yasirACTUALY/Leaf-vac/calibration/right/right_image_1.png

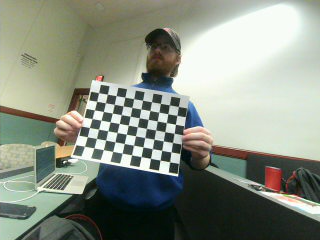
calibration/right/right_image_1.png
