yasirACTUALY/Leaf-vac/calibration/right/right_image_4.png

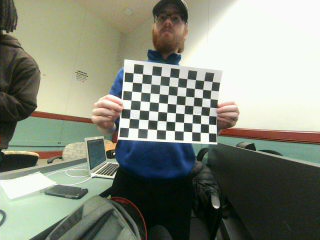
calibration/right/right_image_4.png
