yasirACTUALY/Leaf-vac/C1.jpg

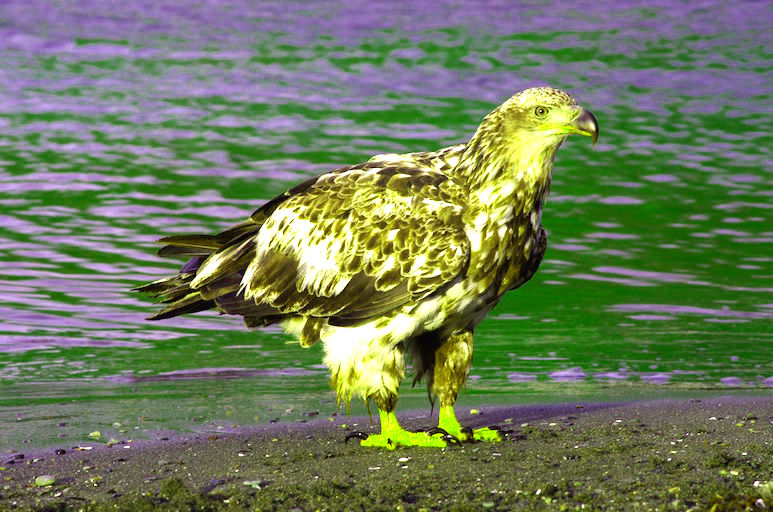
C1.jpg
