yasirACTUALY/Leaf-vac/C2.jpg

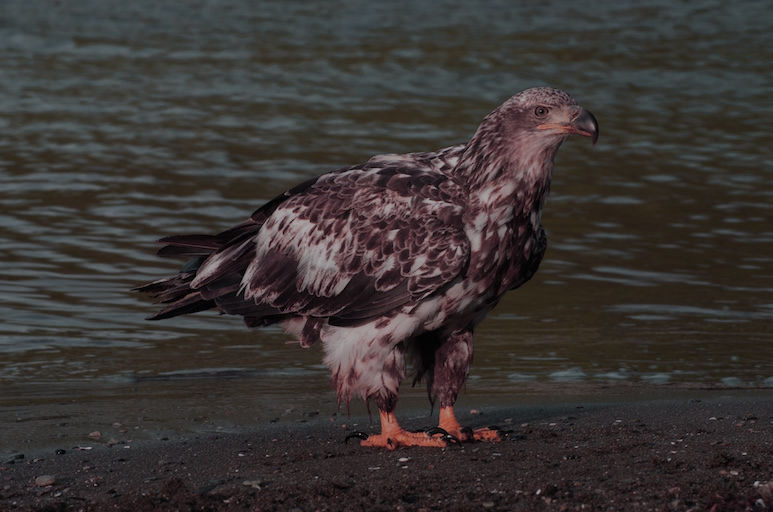
C2.jpg
