yasirACTUALY/Leaf-vac/demo/LeafVac Poster.png

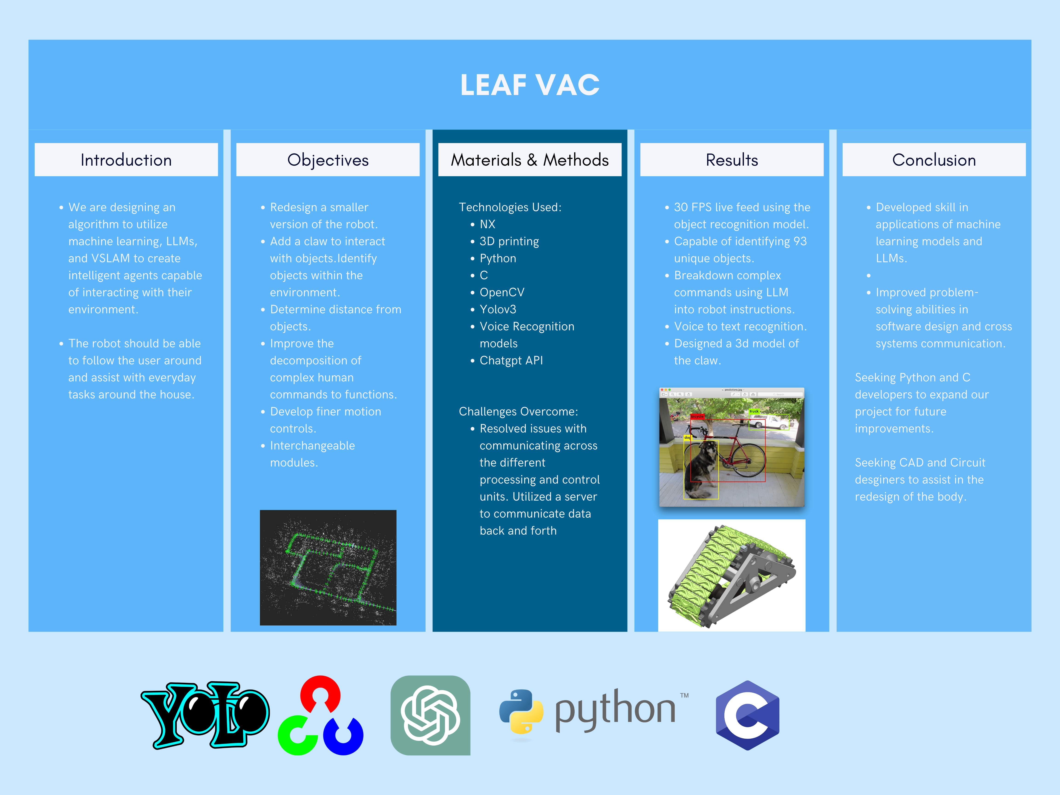
demo/LeafVac Poster.png
