yasirACTUALY/Leaf-vac/CAD/basebase.stl

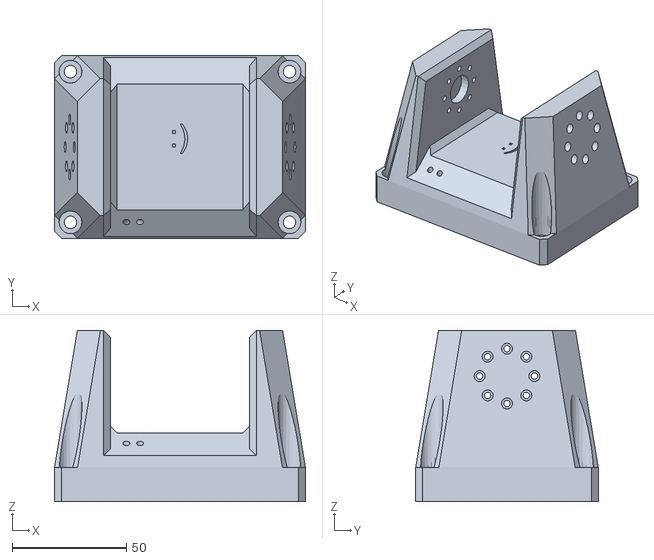
[picture p19: CAD file, 2024-12-07]
CAD/basebase.stl
110.0 x 80.0 x 75.0
