yasirACTUALY/Leaf-vac/CAD/pickupcube.stl

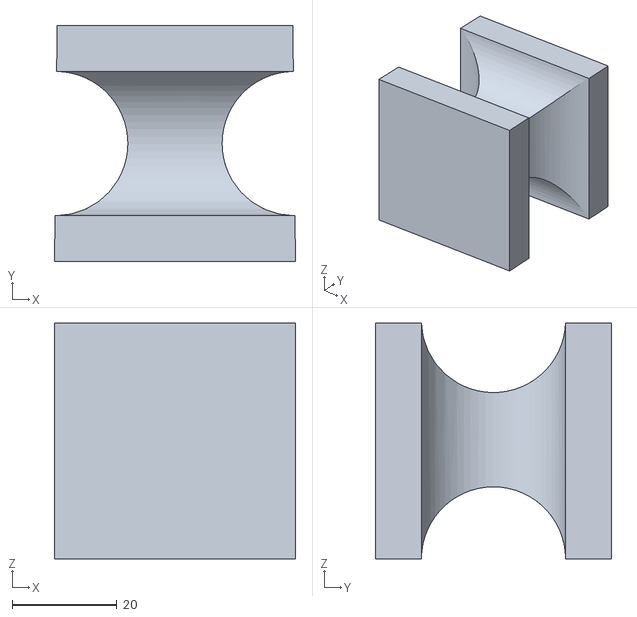
[picture p20: CAD file, 2024-12-07]
CAD/pickupcube.stl
46.0 x 45.0 x 45.0
