yasirACTUALY/Leaf-vac/CAD/basesupport.stl

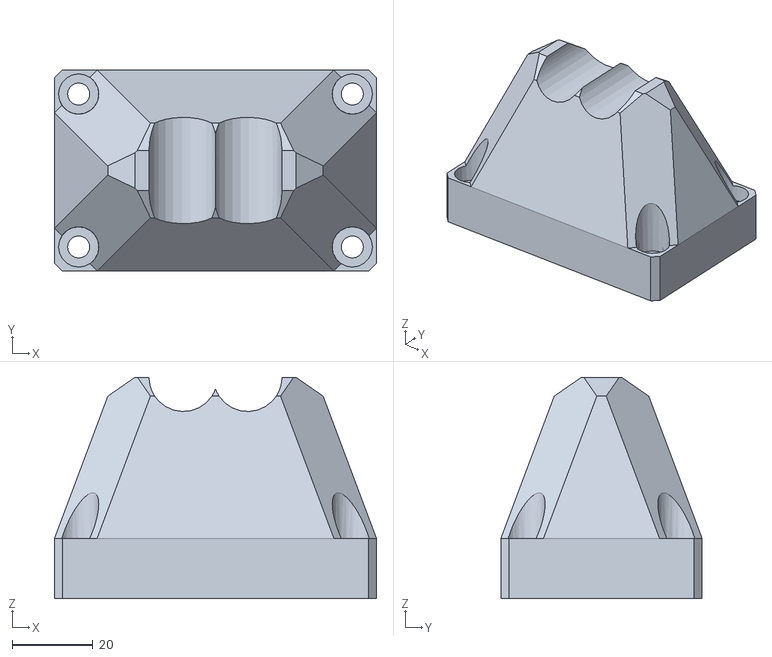
[picture p21: CAD file, 2024-12-07]
CAD/basesupport.stl
80.0 x 50.0 x 55.0
