yasirACTUALY/Leaf-vac/CAD/scoop.stl

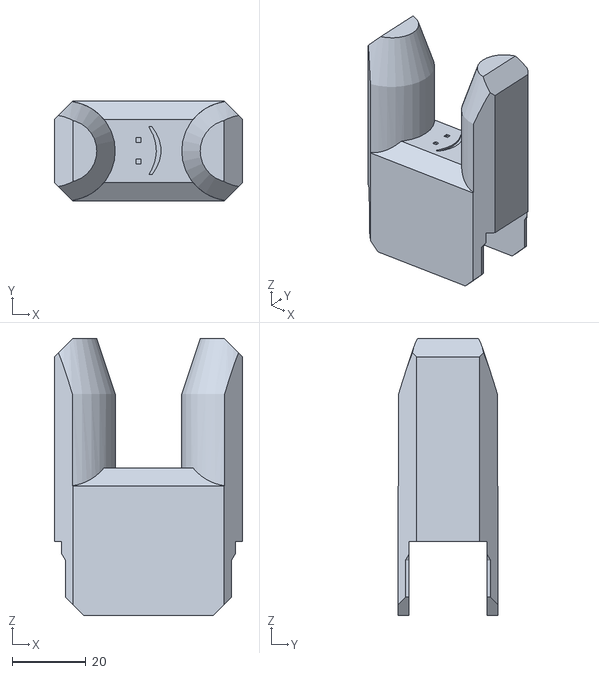
[picture p22: CAD file, 2024-12-07]
CAD/scoop.stl
51.0 x 27.0 x 75.0
