yasirACTUALY/Leaf-vac/CAD/pickupcube_1.stl

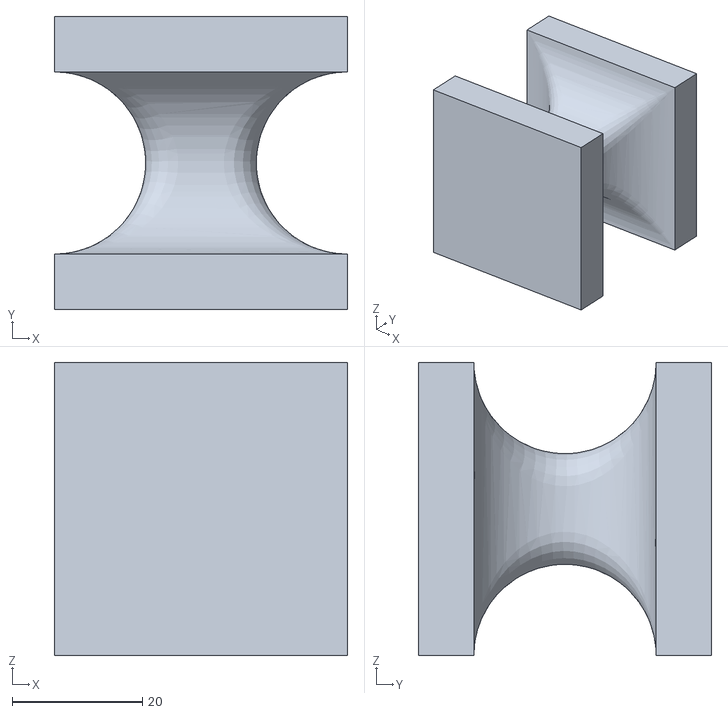
[picture p23: CAD file, 2024-12-07]
CAD/pickupcube_1.stl
45.0 x 45.0 x 45.0
