yasirACTUALY/Leaf-vac/CAD/joint1b.stl

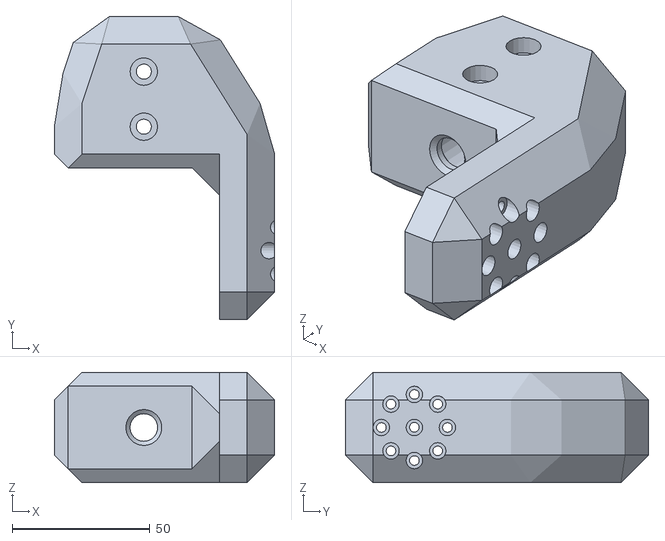
[picture p24: CAD file, 2024-10-22]
CAD/joint1b.stl
80.0 x 110.0 x 40.0
