yasirACTUALY/Leaf-vac/CAD/tubeclamp.stl

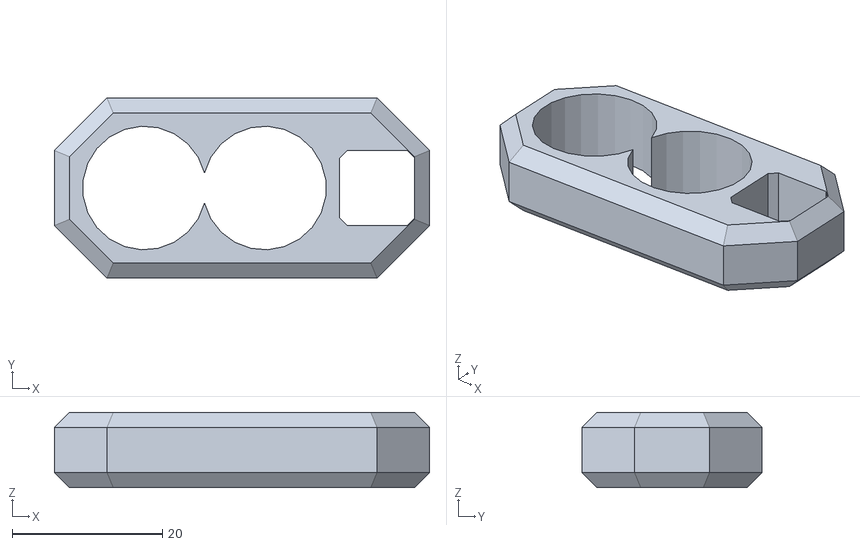
[picture p25: CAD file, 2024-10-22]
CAD/tubeclamp.stl
50.0 x 24.0 x 10.0
