yasirACTUALY/Leaf-vac/CAD/joint1c.stl

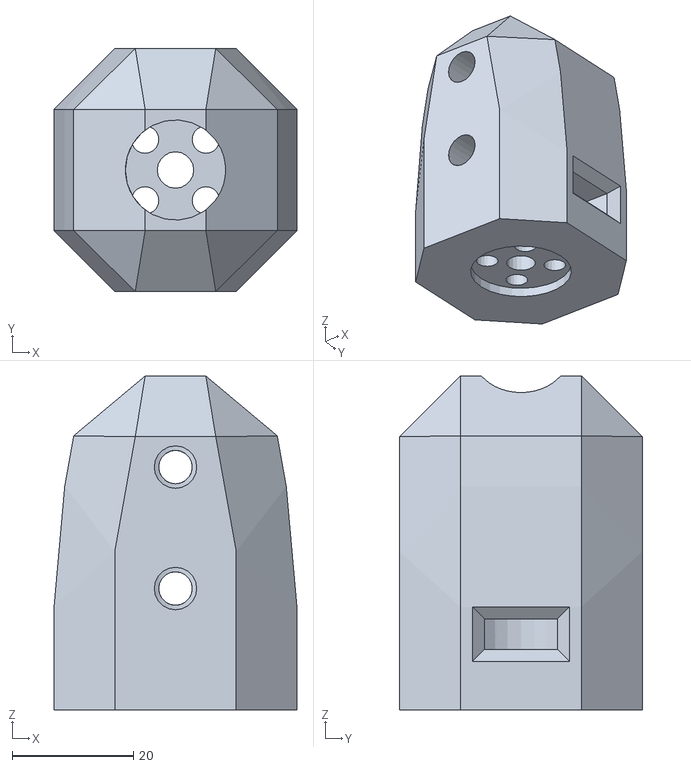
[picture p26: CAD file, 2024-10-22]
CAD/joint1c.stl
40.0 x 40.0 x 55.0
