yasirACTUALY/Leaf-vac/CAD/joint2.stl

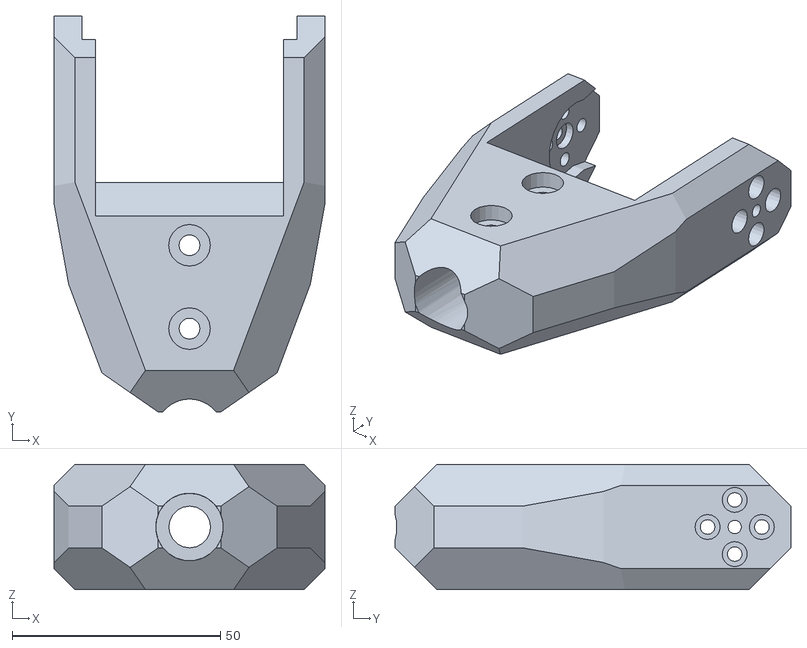
[picture p27: CAD file, 2024-10-22]
CAD/joint2.stl
65.0 x 95.0 x 30.0
