yasirACTUALY/Leaf-vac/CAD/baseb.stl

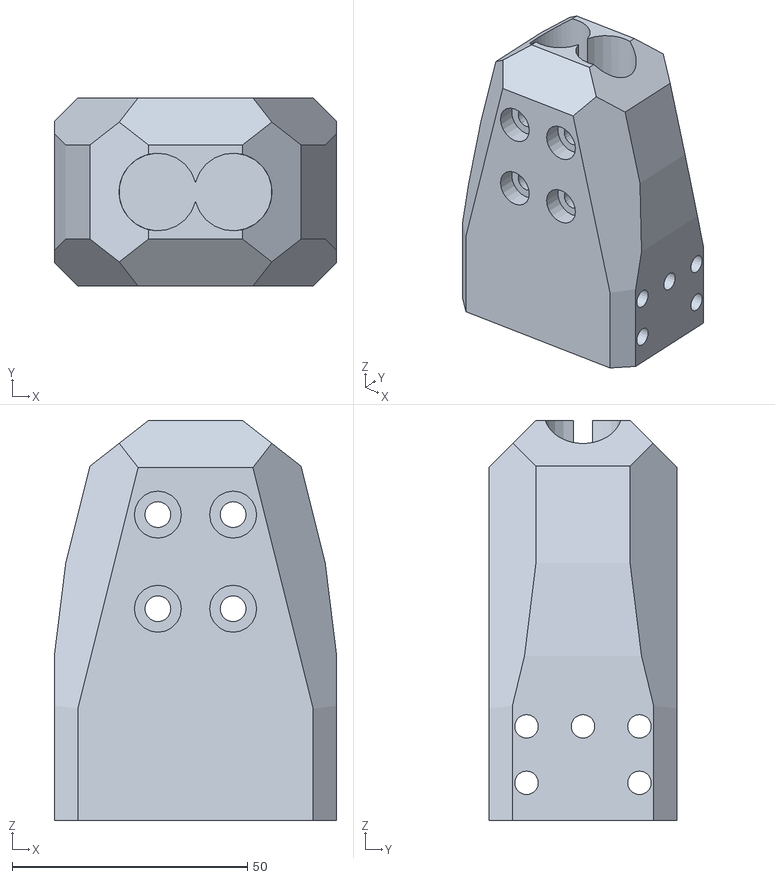
[picture p28: CAD file, 2024-10-22]
CAD/baseb.stl
60.0 x 40.0 x 85.0
