yasirACTUALY/Leaf-vac/CAD/drillblock.stl

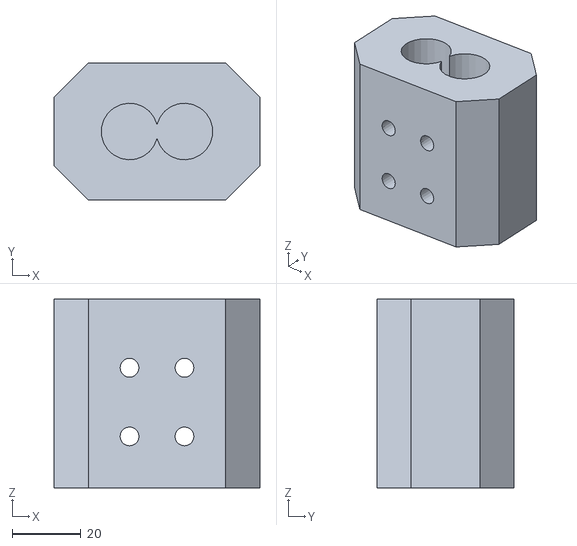
[picture p29: CAD file, 2024-10-22]
CAD/drillblock.stl
60.0 x 40.0 x 55.0
