yasirACTUALY/Leaf-vac/CAD/joint1b2.stl

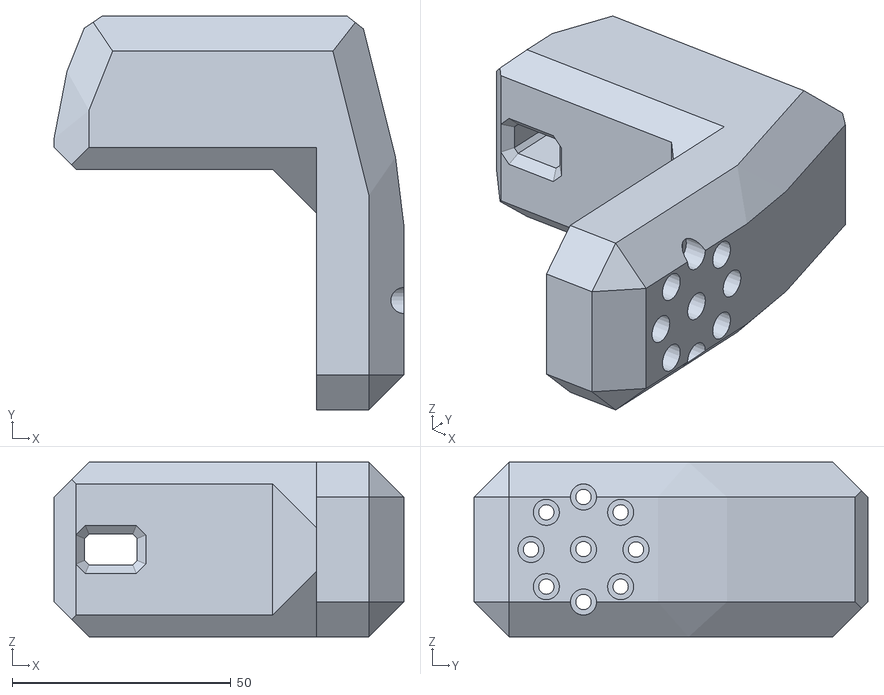
[picture p30: CAD file, 2024-10-22]
CAD/joint1b2.stl
80.0 x 90.0 x 40.0
