yasirACTUALY/Leaf-vac/CAD/joint1.stl

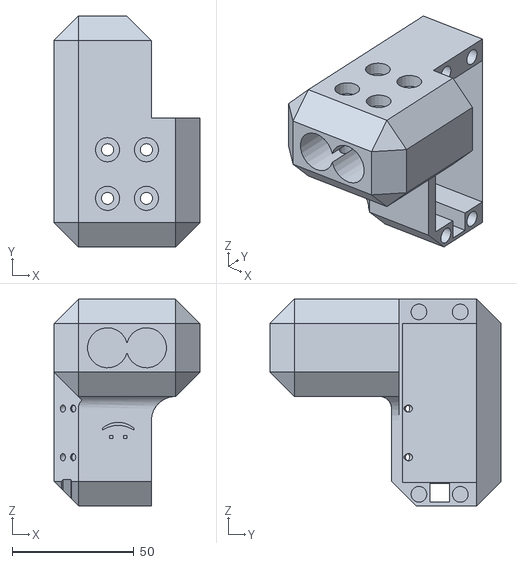
[picture p31: CAD file, 2024-10-11]
CAD/joint1.stl
60.0 x 95.0 x 85.0
