yasirACTUALY/Leaf-vac/CAD/25kgservo.stl

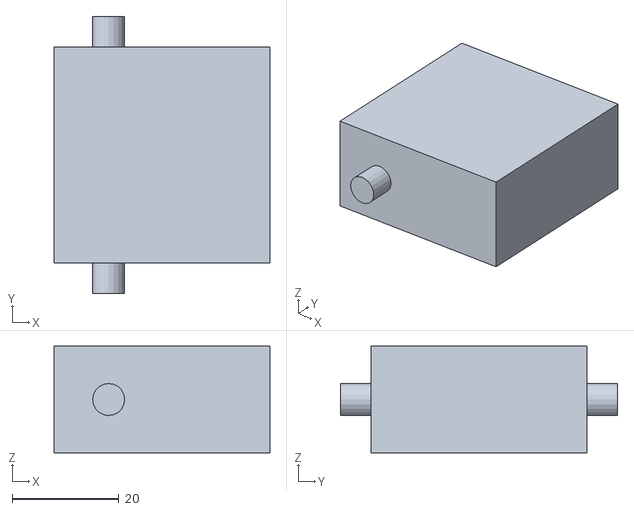
[picture p32: CAD file, 2024-10-11]
CAD/25kgservo.stl
40.5 x 52.0 x 20.0
