yasirACTUALY/Leaf-vac/CAD/80kgservo.stl

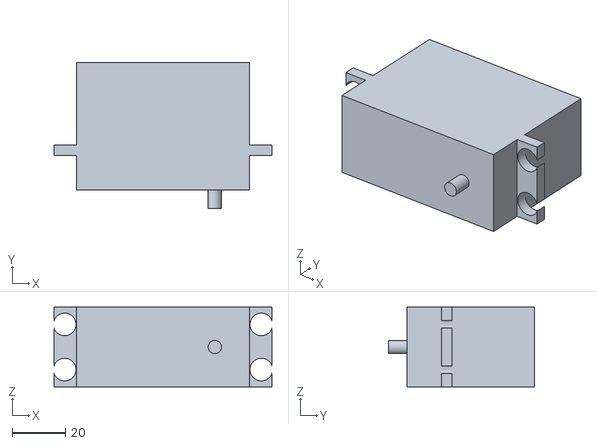
[picture p33: CAD file, 2024-10-04]
CAD/80kgservo.stl
82.0 x 55.0 x 30.0
