yasirACTUALY/Leaf-vac/CAD/carbontube250mm.stl

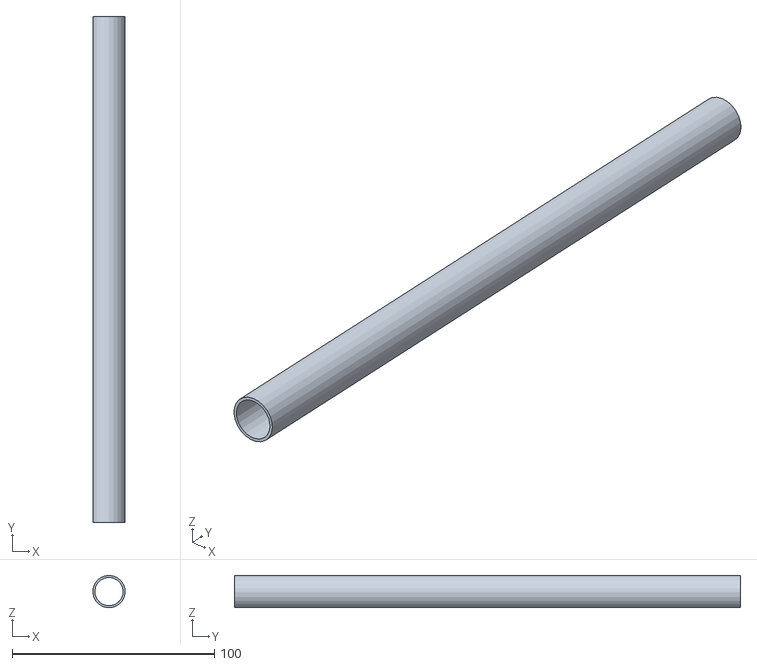
[picture p34: CAD file, 2024-10-04]
CAD/carbontube250mm.stl
16.0 x 250.0 x 15.9
