yasirACTUALY/Leaf-vac/(list of files, cad)

Other CAD files:
CAD/25kgservo.prt
CAD/80kgservo.prt
CAD/baseb.prt
CAD/basebase.prt
CAD/basejoint.prt
CAD/basesupport.prt
CAD/carbontube150mm.prt
CAD/carbontube200mm.prt
CAD/drillblock.prt
CAD/joint1.prt
CAD/joint1b.prt
CAD/joint1b2.prt
CAD/joint1c.prt
CAD/joint2.prt
CAD/pickup.prt
CAD/pickupcube.prt
CAD/scoop.prt
CAD/tubeclamp.prt
