yasirACTUALY/Leaf-vac/Motor Control/Documentation/Wheel Motor Code Test.txt

// Motor A
int motor1Pin1 = 27; 
int motor1Pin2 = 26; 

// Setting PWM properties
const int freq = 30000;
const int pwmChannel = 0;
const int resolution = 8;
int dutyCycle = 200;

void setup() {
  // sets the pins as outputs:
  pinMode(motor1Pin1, OUTPUT);
  pinMode(motor1Pin2, OUTPUT);
  
}

void loop() {
  // Move the DC motor forward at maximum speed
  digitalWrite(motor1Pin1, LOW);
  digitalWrite(motor1Pin2, HIGH); 
  delay(2000);

  // Stop the DC motor
  digitalWrite(motor1Pin1, LOW);
  digitalWrite(motor1Pin2, LOW);
  delay(1000);

  // Move DC motor backwards at maximum speed
  digitalWrite(motor1Pin1, HIGH);
  digitalWrite(motor1Pin2, LOW); 
  delay(2000);

}
