yasirACTUALY/Leaf-vac/calibration/left/left_image_1.png

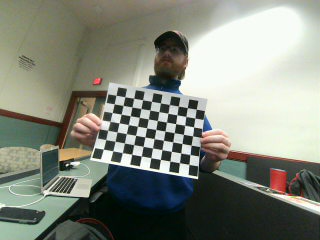
calibration/left/left_image_1.png
