yasirACTUALY/Leaf-vac/calibration/left/left_image_2.png

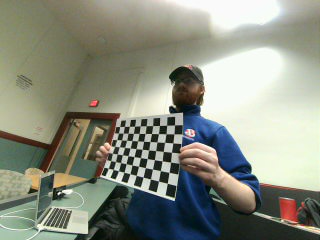
calibration/left/left_image_2.png
