yasirACTUALY/Leaf-vac/calibration/left/left_image_3.png

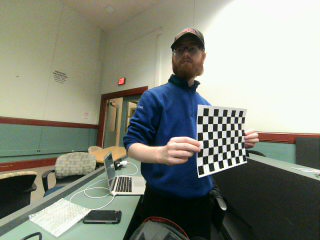
calibration/left/left_image_3.png
