yasirACTUALY/Leaf-vac/calibration/left/left_image_4.png

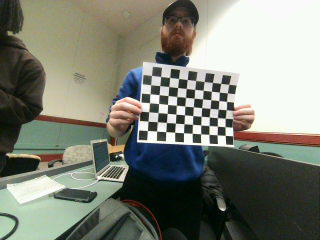
calibration/left/left_image_4.png
