yasirACTUALY/Leaf-vac/calibration/left/left_image_5.png

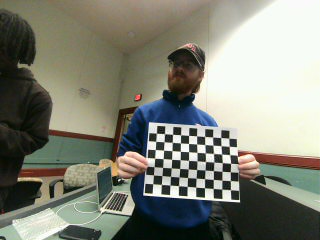
calibration/left/left_image_5.png
