yasirACTUALY/Leaf-vac/calibration/right/right_image_2.png

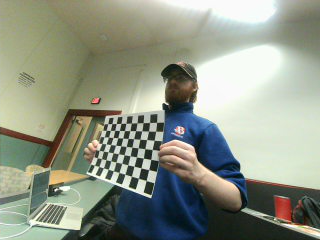
calibration/right/right_image_2.png
