yasirACTUALY/Leaf-vac/calibration/right/right_image_3.png

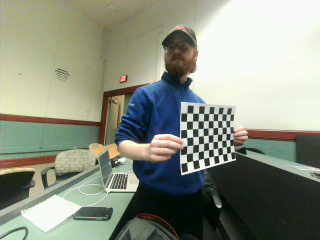
calibration/right/right_image_3.png
