yasirACTUALY/Leaf-vac/calibration/right/right_image_5.png

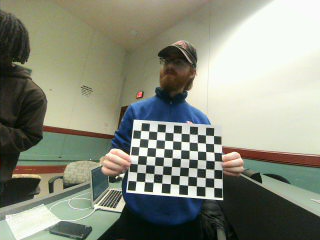
calibration/right/right_image_5.png
