yasirACTUALY/Leaf-vac/(commit log)

2024-07-12 added custom cfg file
    [alexnet.cfg, cifar.cfg, cifar.test.cfg, custom.cfg, darknet.cfg, darknet19.cfg, darknet19_448.cfg, darknet53.cfg]
2024-08-13 added file to communicate commands to the robot wirelessly
2024-08-13 added a screenCapture and object detection to gain the ability to transfer camera visuals using a live stream/video call
2024-10-04 CAD file
    [80kgservo.prt, 80kgservo.stl, basejoint.prt, carbontube150mm.prt, carbontube200mm.prt, carbontube250mm.stl, joint1.prt, joint1.stl]
2024-10-11 CAD update 2
    [25kgservo.prt, 25kgservo.stl, joint1.prt, joint1.stl, joint1b.prt, joint1b.stl, joint2.prt, joint2.stl]
2024-10-11 I added in documentation for the servo motors.
2024-10-20 CAD update 3
    [baseb.prt, baseb.stl, drillblock.prt, drillblock.stl, joint1b.prt, joint1b.stl, joint1b2.prt, joint1b2.stl]
2024-10-22 added calibration for both cameras individually using a checker board
2024-10-25 Servo Controller not required, also no enable pin needed.
2024-10-25 Wheel Motor Control Testing Code
2024-11-03 First attempt at servo arm code
    First prototype of servo code
2024-11-03 Second attempt at servo arm code
    Our second attempt in which we added outside inputs to change angle at which motor will go to.
2024-11-03 Servo code testing results
    The success and failures of the tests, and what we found that needs to be changed.
2024-11-03 Voltage Divider Work
    How we are working to lower voltage, with the problem of current and possible solutions.
2024-11-08 CAD Update
    [basebase.prt, basebase.stl]
2024-11-09 Servo Arm Code fixed errors
    Doesent go back to 0 and is accurate
2024-11-09 Description of Servo Testing
    This is the second week of testing the servo. Using the no error code now and what was done to fix it. And new errors
2024-11-15 CAD Update 11/15
    [basebase.prt, basebase.stl, basesupport.prt, basesupport.stl]
2024-12-07 Final CAD Update
    [pickup.prt, pickupcube.prt, pickupcube.stl, pickupcube_1.stl, scoop.prt, scoop.stl]
2024-12-11 added calibration images from teh stereo camera
2024-12-11 added the a function to combine the intrinsic parameter of the cameras to produce the rotation and translation matrix between the cameras
2024-12-11 added code used to view the live camera feed and to save photos for testing
